ripaaf/ups-orangepizero3w/README.md

# ups-orangepizero3w
trying making a pcb ups for orangepi (its bad)
