ripaaf/ups-orangepizero3w/OrangePi_Zero3W_UPS_RevA.kicad_pcb

## KiCad design OrangePi_Zero3W_UPS_RevA.kicad_pcb (2026-08-08)

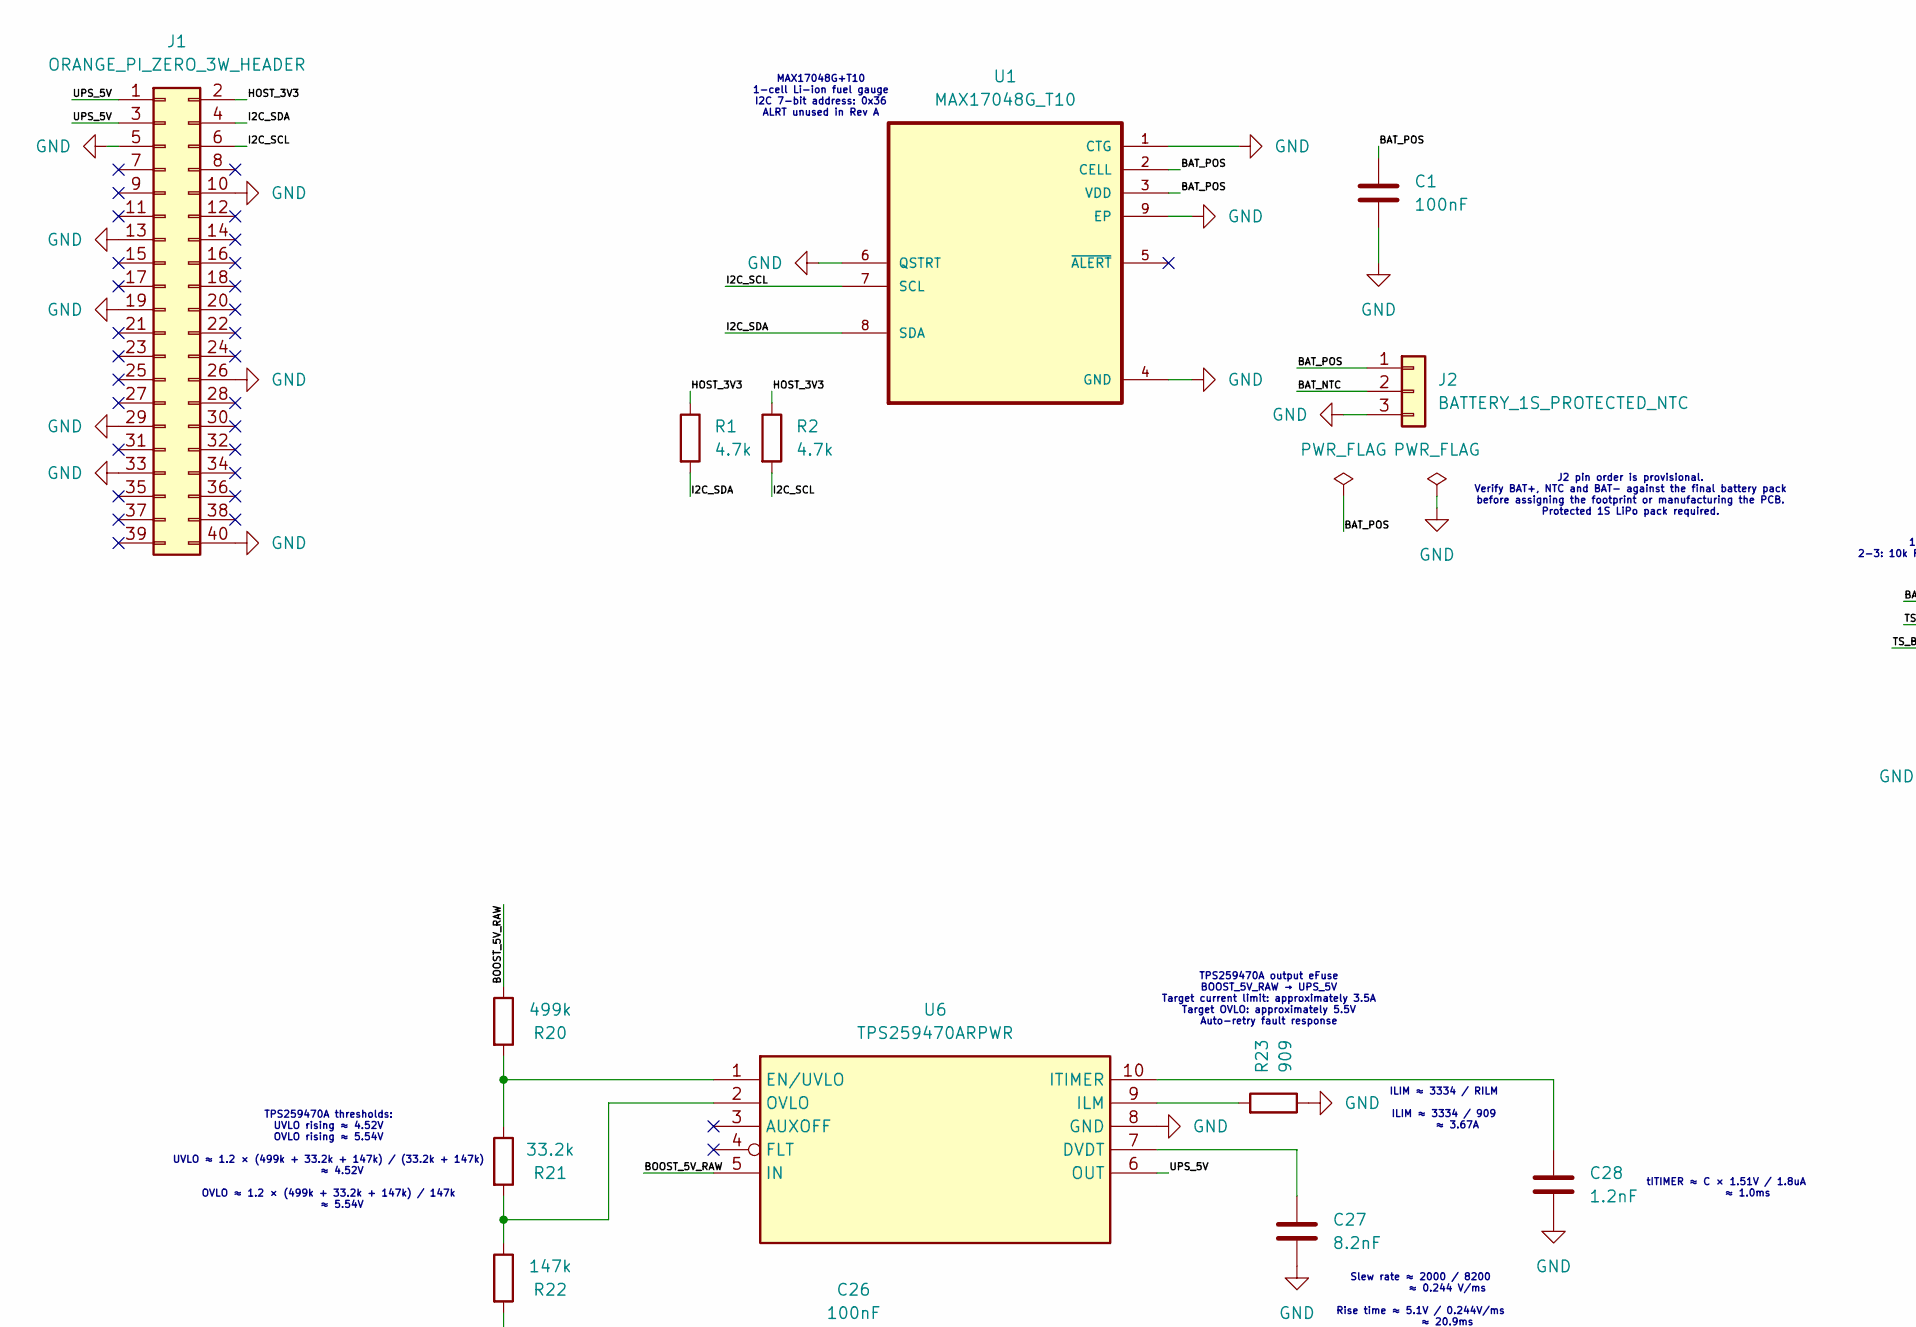
[picture p1: schematic OrangePi_Zero3W_UPS_RevA.kicad_sch, part in row 1, column 1]

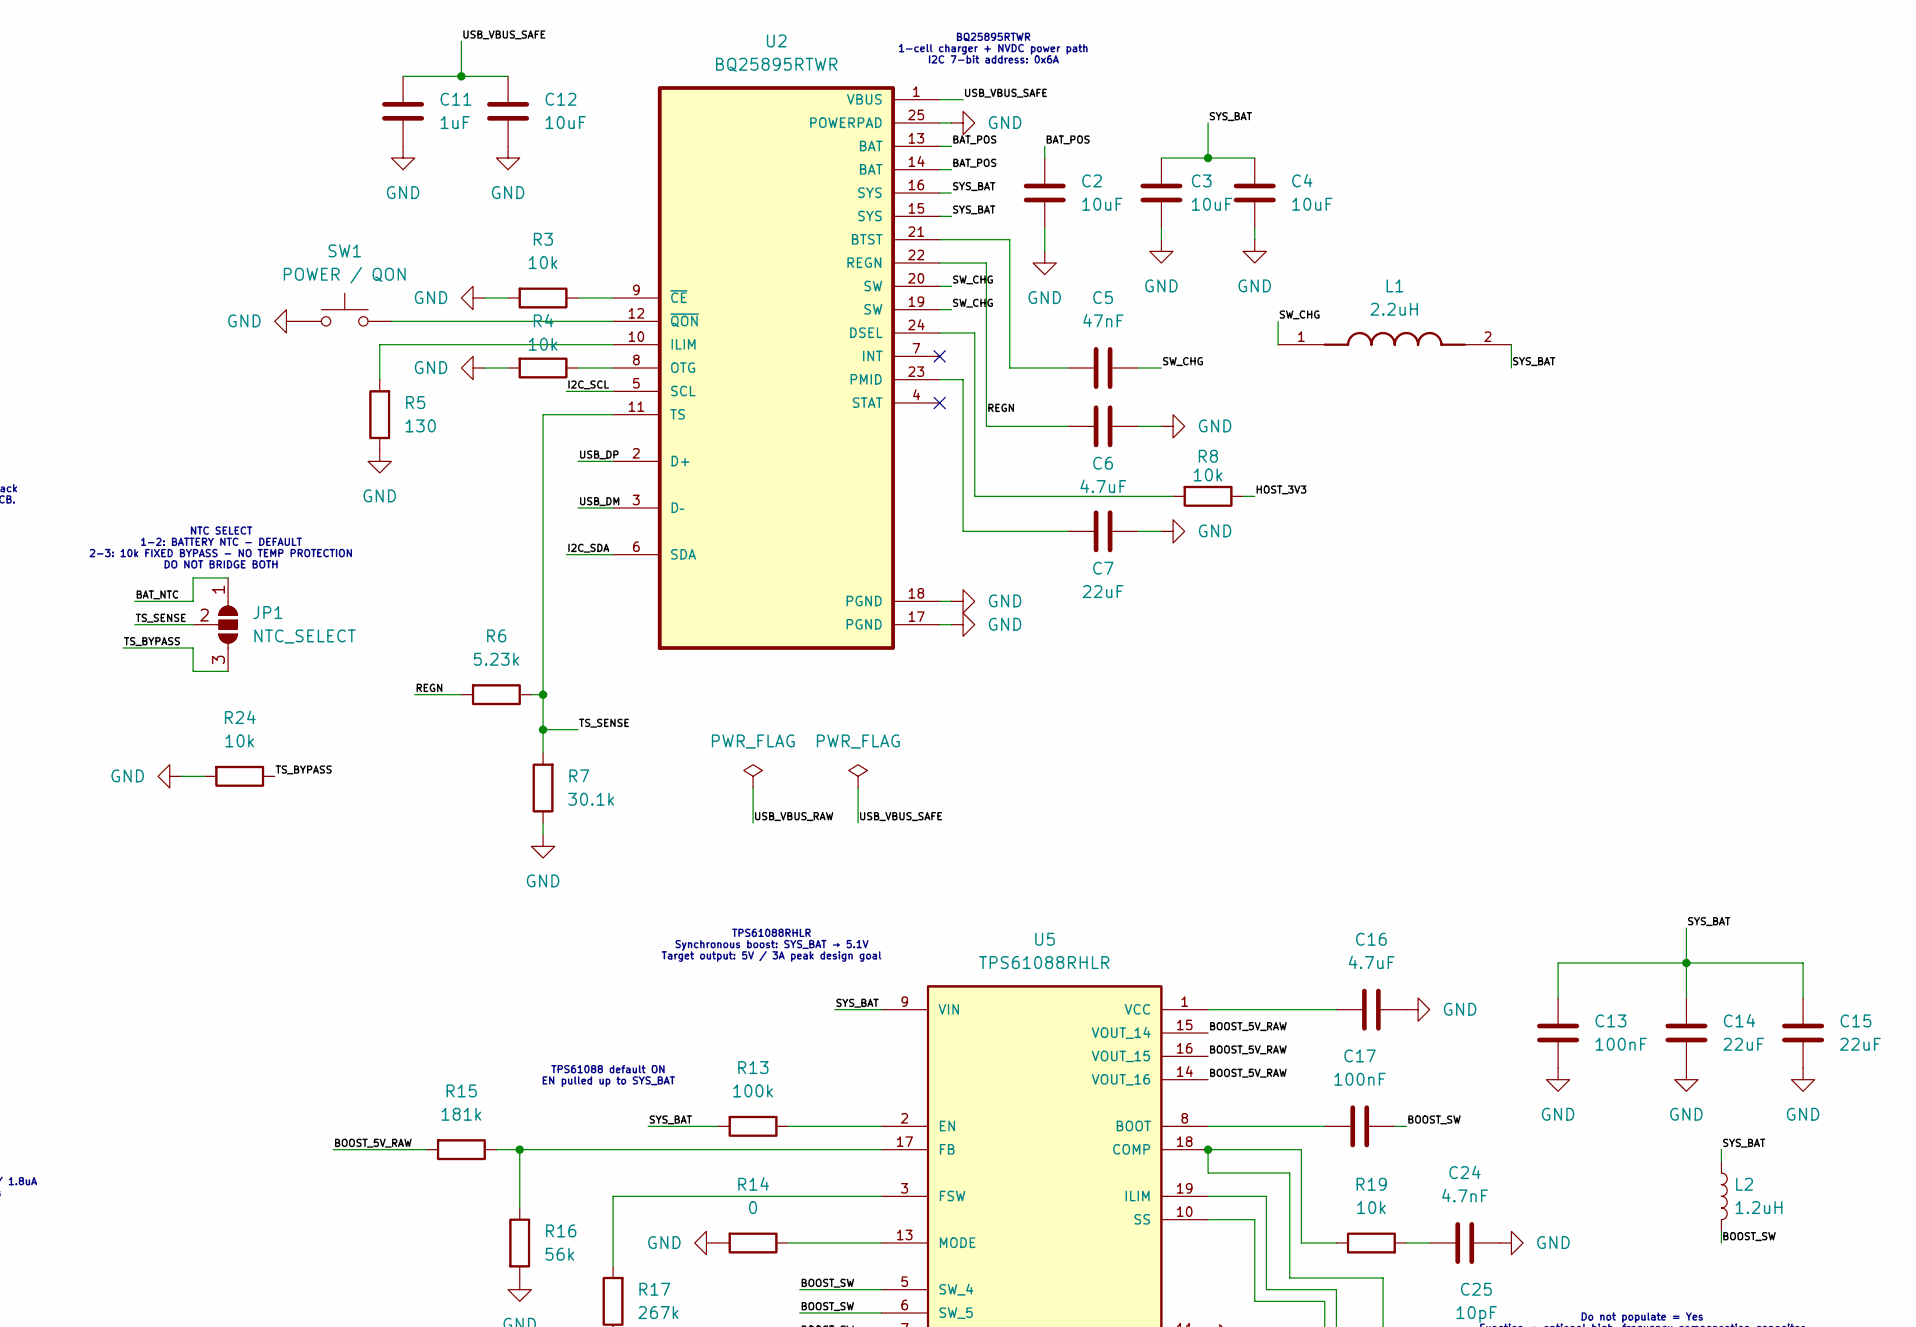
[picture p2: schematic OrangePi_Zero3W_UPS_RevA.kicad_sch, part in row 1, column 2]

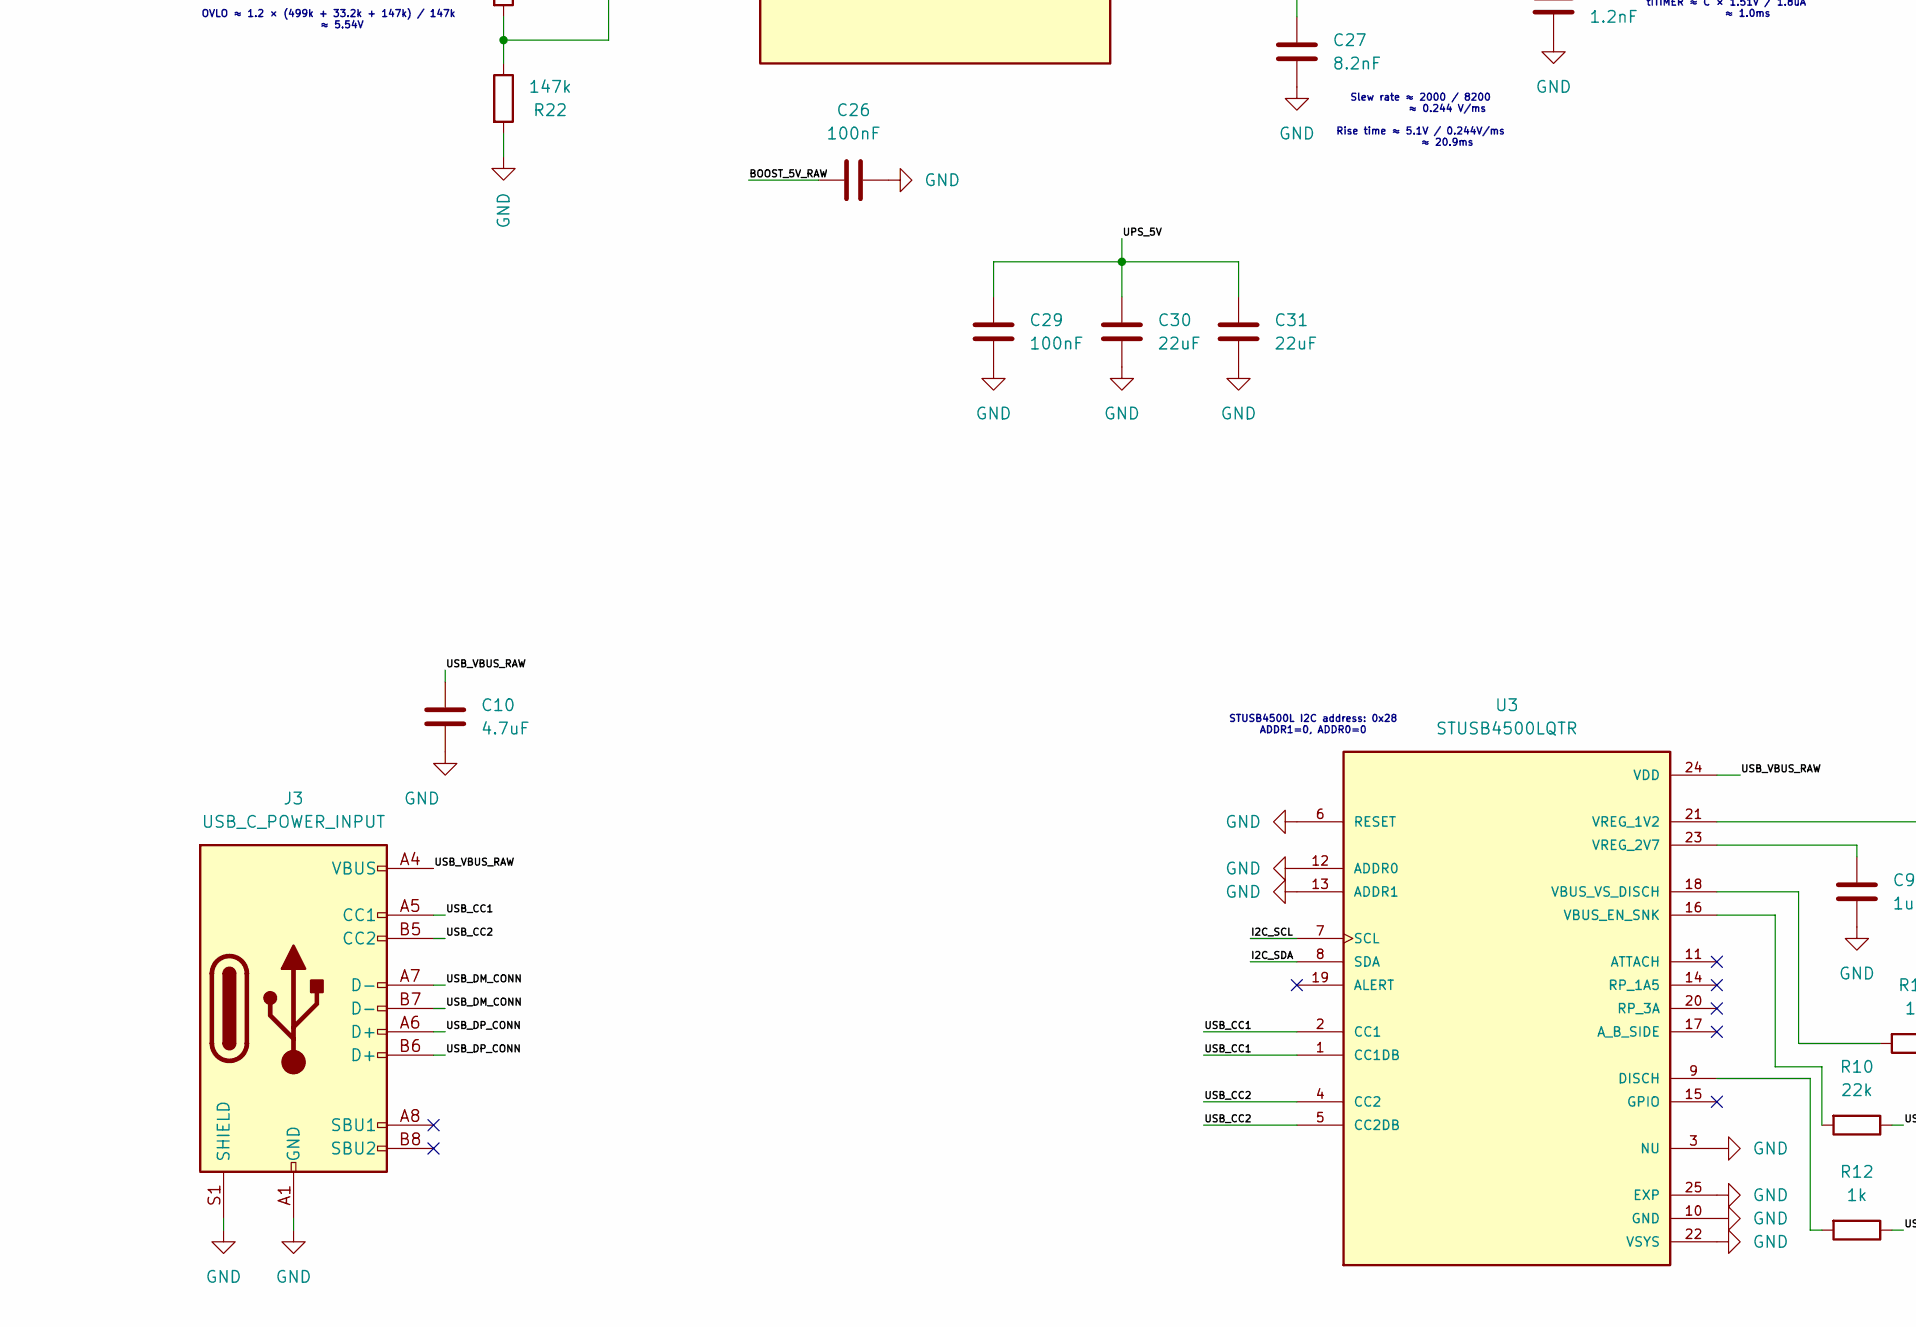
[picture p3: schematic OrangePi_Zero3W_UPS_RevA.kicad_sch, part in row 2, column 1]

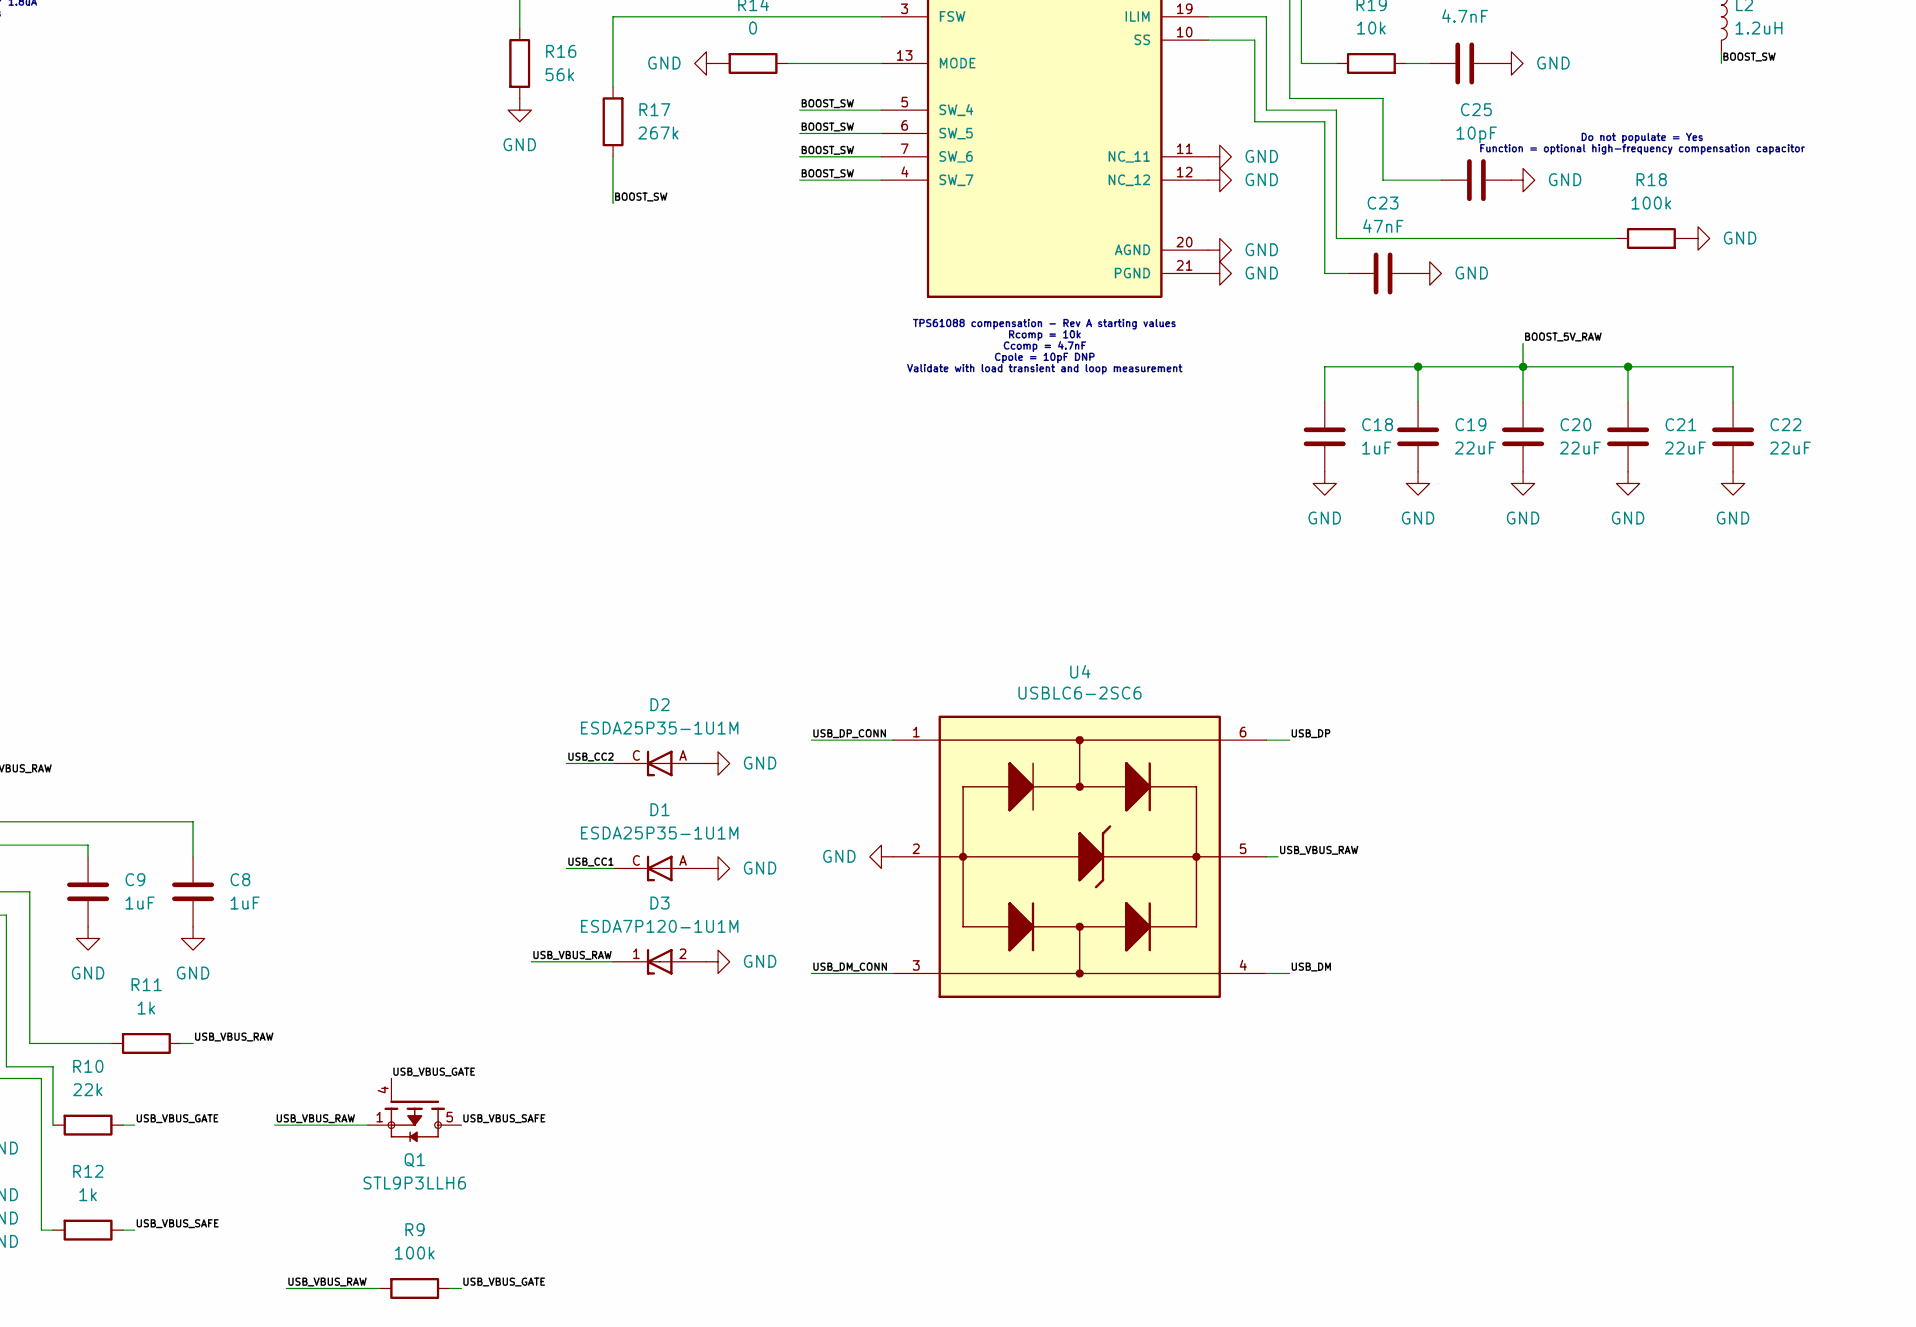
[picture p4: schematic OrangePi_Zero3W_UPS_RevA.kicad_sch, part in row 2, column 2]

Parts:
C1: 100nF; C_0603_1608Metric
C2, C3, C4: 10uF; C_0805_2012Metric
C5: 47nF; C_0402_1005Metric; Voltage minimum 16V
C6, C16: 4.7uF; C_0603_1608Metric; Voltage 10V minimum
C7: 22uF; C_0805_2012Metric; Voltage 25V; MPN GRM21BR61E226ME44
C8, C9: 1uF; C_0603_1608Metric; Voltage 6.3V or higher
C10: 4.7uF; C_0805_2012Metric; Voltage rating minimal 10V
C11: 1uF; C_0805_2012Metric; Voltage rating minimal 25V; MPN GRM219R71E105KA88D
C12: 10uF; C_0805_2012Metric; Voltage rating minimal 25V; MPN C2012X5R1E106K125AB
C13, C26, C29: 100nF; C_0603_1608Metric; Voltage 10V minimum
C14, C15, C19, C20, C21, C22, C30, C31: 22uF; C_1206_3216Metric; Voltage 10V minimum
C17: 100nF; C_0402_1005Metric; Voltage 16V minimum
C18: 1uF; C_0603_1608Metric; Voltage 10V minimum
C23: 47nF; C_0402_1005Metric; Voltage 10V minimum
C24: 4.7nF; C_0402_1005Metric; Voltage 10V minimum
C25: 10pF; C_0402_1005Metric; Voltage 25V atau lebih
C27: 8.2nF; C_0402_1005Metric; Voltage 10V minimum
C28: 1.2nF; C_0402_1005Metric; Voltage 10V minimum
D1, D2: ESDA25P35-1U1M; TVS_ESDA25P35-1U1M; PARTREV 2
D3: ESDA7P120-1U1M; TVS_ESDA7P120-1U1M; PARTREV 4
J1: ORANGE_PI_ZERO_3W_HEADER; PinSocket_2x20_P2.54mm_Vertical
J2: BATTERY_1S_PROTECTED_NTC; JST_PH_S3B-PH-SM4-TB_1x03-1MP_P2.00mm_Horizontal
J3: USB_C_POWER_INPUT; USB_C_Receptacle_JAE_DX07S016JA1R1500; MPN DX07S016JA1R1500
JP1: NTC_SELECT; SolderJumper-3_P1.3mm_Open_Pad1.0x1.5mm_NumberLabels
L1: 2.2uH; INDM686X647X300N; PARTREV 16-Oct-2020
L2: 1.2uH; Coilcraft_XGL6030; Tolerance ±20%; MPN XGL6030-122MEC
Q1: STL9P3LLH6; TRANS_STL9P3LLH6; PARTREV 3
R1, R2: 4.7k; R_0603_1608Metric
R3, R4, R8: 10k; R_0603_1608Metric
R5: 130; R_0603_1608Metric; Tolerance 1%
R6: 5.23k; R_0603_1608Metric; Tolerance 1%
R7: 30.1k; R_0603_1608Metric; Tolerance 1%
R9, R13: 100k; R_0603_1608Metric
R10: 22k; R_0603_1608Metric
R11, R12: 1k; R_0603_1608Metric
R14: 0; R_0603_1608Metric
R15: 181k; R_0603_1608Metric; tolerance 1%
R16: 56k; R_0603_1608Metric; tolerance 1%
R17: 267k; R_0603_1608Metric; tolerance 1%
R18: 100k; R_0603_1608Metric; tolerance 1%
R19: 10k; R_0603_1608Metric; tolerance 1%
R20: 499k; R_0603_1608Metric; tolerance 1%
R21: 33.2k; R_0603_1608Metric; tolerance 1%
R22: 147k; R_0603_1608Metric; tolerance 1%
R23: 909; R_0603_1608Metric; tolerance 1%
R24: 10k; R_0603_1608Metric; Tolerance 1%
SW1: POWER / QON; SW_B3U-1000P
U1: MAX17048G_T10; SON50P200X200X80-9N; MPN MAX17048G+T10
U2: BQ25895RTWR; QFN50P400X400X80-25N; MPN BQ25895RTWR
U3: STUSB4500LQTR; QFN50P400X400X100-25N; PARTREV 4
U4: USBLC6-2SC6; SOT95P280X145-6N; MPN USBLC6-2SC6
U5: TPS61088RHLR; IC_TPS61088RHLR; PARTREV 4219071/A 05/2017; LCSC Part # C87357
U6: TPS259470ARPWR; TPS259470ARPWR_RPW0010A; MPN TPS259470ARPWR

Connections:
/BAT_NTC: J2.2, JP1.1 (A)
/BAT_POS: C1.1, C2.1, J2.1, U1.2 (CELL), U1.3 (VDD), U2.13 (BAT), U2.14 (BAT)
/BOOST_5V_RAW: C18.1, C19.1, C20.1, C21.1, C22.1, C26.2, R15.2, R20.1, U5.14 (VOUT_16), U5.15 (VOUT_14), U5.16 (VOUT_15), U6.5 (IN)
/BOOST_SW: C17.1, L2.2, R17.1, U5.4 (SW_7), U5.5 (SW_4), U5.6 (SW_5), U5.7 (SW_6)
/HOST_3V3: J1.2, R1.1, R2.1, R8.1
/I2C_SCL: J1.6, R2.2, U1.7 (SCL), U2.5 (SCL), U3.7 (SCL)
/I2C_SDA: J1.4, R1.2, U1.8 (SDA), U2.6 (SDA), U3.8 (SDA)
/REGN: C6.2, R6.2, U2.22 (REGN)
/SW_CHG: C5.1, L1.1, U2.19 (SW), U2.20 (SW)
/SYS_BAT: C3.1, C4.1, C13.1, C14.1, C15.1, L1.2, L2.1, R13.2, U2.15 (SYS), U2.16 (SYS), U5.9 (VIN)
/TS_BYPASS: JP1.3 (B), R24.1
/TS_SENSE: JP1.2 (C), R6.1, R7.2, U2.11 (TS)
/UPS_5V: C29.2, C30.2, C31.2, J1.1, J1.3, U6.6 (OUT)
/USB_CC1: D1.C, J3.A5 (CC1), U3.1 (CC1DB), U3.2 (CC1)
/USB_CC2: D2.C, J3.B5 (CC2), U3.4 (CC2), U3.5 (CC2DB)
/USB_DM: U2.3 (D–), U4.4
/USB_DM_CONN: J3.A7 (D-), J3.B7 (D-), U4.3
/USB_DP: U2.2 (D+), U4.6
/USB_DP_CONN: J3.A6 (D+), J3.B6 (D+), U4.1
/USB_VBUS_GATE: Q1.4, R9.1, R10.1
/USB_VBUS_RAW: C10.1, D3.1, J3.A4 (VBUS), J3.A9 (VBUS), J3.B4 (VBUS), J3.B9 (VBUS), Q1.1, Q1.2, Q1.3, R9.2, R11.1, U3.24 (VDD), U4.5
/USB_VBUS_SAFE: C11.1, C12.1, Q1.5, Q1.5_1, Q1.5_2, R12.1, U2.1 (VBUS)
GND: C1.2, C2.2, C3.2, C4.2, C6.1, C7.2, C8.2, C9.2, C10.2, C11.2, C12.2, C13.2, C14.2, C15.2, C16.2, C18.2, C19.2, C20.2, C21.2, C22.2, C23.1, C24.1, C25.1, C26.1, C27.1, C28.1, C29.1, C30.1, C31.1, D1.A, D2.A, D3.2, J1.5, J1.10, J1.13, J1.19, J1.26, J1.29, J1.33, J1.40, J2.3, J3.A1 (GND), J3.A12 (GND), J3.B1 (GND), J3.B12 (GND), J3.S1 (SHIELD), R3.2, R4.2, R5.1, R7.1, R14.2, R16.2, R18.2, R22.2, R23.1, R24.2, SW1.1, U1.1 (CTG), U1.4 (GND), U1.6 (QSTRT), U1.9 (EP), U2.17 (PGND), U2.18 (PGND), U2.25 (POWERPAD), U3.3 (NU), U3.6 (RESET), U3.10 (GND), U3.12 (ADDR0), U3.13 (ADDR1), U3.22 (VSYS), U3.25 (EXP), U4.2, U5.11 (NC_11), U5.12 (NC_12), U5.20 (AGND), U5.21 (PGND), U6.8 (GND)
unnamed: C24.2, R19.2
unnamed: C5.2, U2.21 (BTST)
unnamed: R8.2, U2.24 (DSEL)
unnamed: R5.2, U2.10 (ILIM)
unnamed: R4.1, U2.8 (OTG)
unnamed: C7.1, U2.23 (PMID)
unnamed: R3.1, U2.9 (~CE)
unnamed: SW1.2, U2.12 (~QON)
unnamed: R12.2, U3.9 (DISCH)
unnamed: R10.2, U3.16 (VBUS_EN_SNK)
unnamed: R11.2, U3.18 (VBUS_VS_DISCH)
unnamed: C8.1, U3.21 (VREG_1V2)
unnamed: C9.1, U3.23 (VREG_2V7)
unnamed: C17.2, U5.8 (BOOT)
unnamed: C25.2, R19.1, U5.18 (COMP)
unnamed: R13.1, U5.2 (EN)
unnamed: R15.1, R16.1, U5.17 (FB)
unnamed: R17.2, U5.3 (FSW)
unnamed: R18.1, U5.19 (ILIM)
unnamed: R14.1, U5.13 (MODE)
unnamed: C23.2, U5.10 (SS)
unnamed: C16.1, U5.1 (VCC)
unnamed: C27.2, U6.7 (DVDT)
unnamed: R20.2, R21.1, U6.1 (EN/UVLO)
unnamed: R23.2, U6.9 (ILM)
unnamed: C28.2, U6.10 (ITIMER)
unnamed: R21.2, R22.1, U6.2 (OVLO)

Notes on the sheet:
NTC SELECT 1-2: BATTERY NTC - DEFAULT 2-3: 10k FIXED BYPASS - NO TEMP PROTECTION DO NOT BRIDGE BOTH
TPS61088RHLR Synchronous boost: SYS_BAT → 5.1V Target output: 5V / 3A peak design goal
STUSB4500L I2C address: 0x28 ADDR1=0, ADDR0=0
Slew rate ≈ 2000 / 8200 ≈ 0.244 V/ms Rise time ≈ 5.1V / 0.244V/ms ≈ 20.9ms
Do not populate = Yes Function = optional high-frequency compensation capacitor
J2 pin order is provisional. Verify BAT+, NTC and BAT- against the final battery pack before assigning the footprint or manufacturing the PCB. Protected 1S LiPo pack required.
TPS61088 default ON EN pulled up to SYS_BAT
TPS259470A output eFuse BOOST_5V_RAW → UPS_5V Target current limit: approximately 3.5A Target OVLO: approximately 5.5V Auto-retry fault response
tITIMER ≈ C × 1.51V / 1.8uA ≈ 1.0ms
ILIM ≈ 3334 / RILM ILIM ≈ 3334 / 909 ≈ 3.67A
TPS259470A thresholds: UVLO rising ≈ 4.52V OVLO rising ≈ 5.54V UVLO ≈ 1.2 × (499k + 33.2k + 147k) / (33.2k + 147k) ≈ 4.52V OVLO ≈ 1.2 × (499k + 33.2k + 147k) / 147k ≈ 5.54V
TPS61088 compensation - Rev A starting values Rcomp = 10k Ccomp = 4.7nF Cpole = 10pF DNP Validate with load transient and loop measurement
BQ25895RTWR 1-cell charger + NVDC power path I2C 7-bit address: 0x6A
MAX17048G+T10 1-cell Li-ion fuel gauge I2C 7-bit address: 0x36 ALRT unused in Rev A

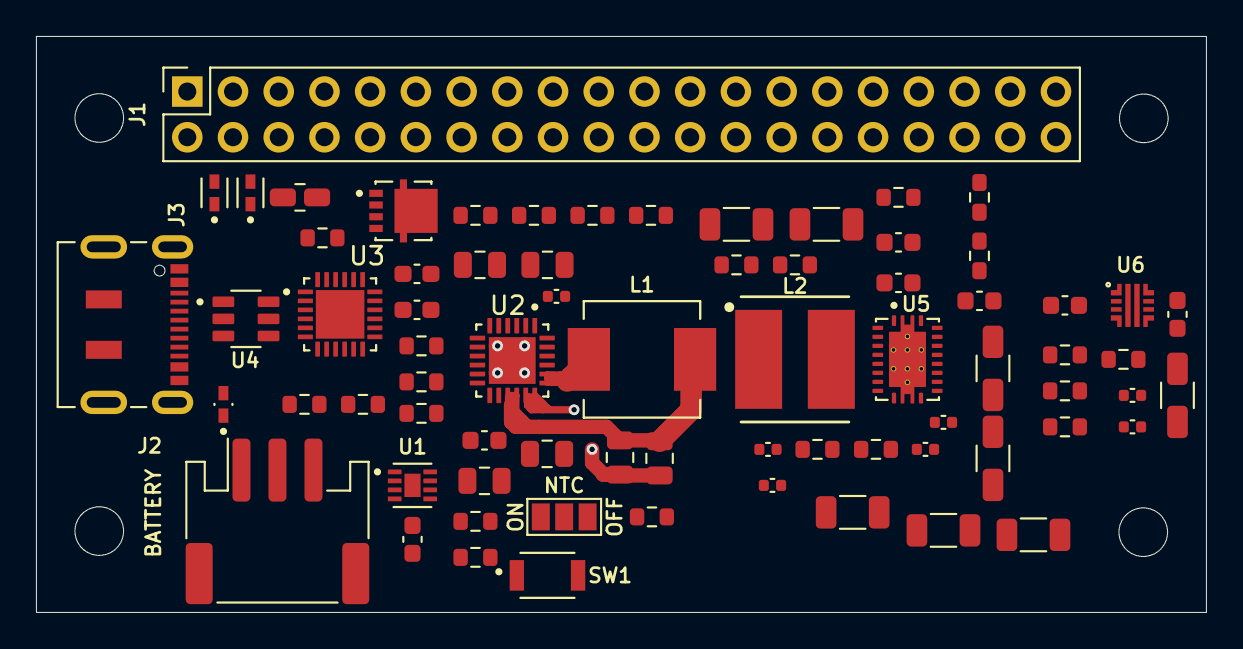
[picture p5: board OrangePi_Zero3W_UPS_RevA.kicad_pcb from above]

Board: 4 copper layers, 65.0 x 32.0 mm, 72 parts (0 on the bottom side), 50 nets.
