ripaaf/ups-orangepizero3w/(commit log)

2026-07-31 phase 4
    [OrangePi_Zero3W_UPS_RevA.kicad_pcb, OrangePi_Zero3W_UPS_RevA.kicad_sch]
2026-08-01 update phase 5A.1
    [OrangePi_Zero3W_UPS_RevA.kicad_pcb, OrangePi_Zero3W_UPS_RevA.kicad_sch]
2026-08-01 phase 5a.1 revision
    [OrangePi_Zero3W_UPS_RevA.kicad_pcb]
2026-08-01 phase 5A.2
    [OrangePi_Zero3W_UPS_RevA.kicad_sch]
2026-08-01 phase 5A.2 revisi
    [OrangePi_Zero3W_UPS_RevA.kicad_pcb]
2026-08-01 Phase 5A.3: add provisional protected battery interface
    [OrangePi_Zero3W_UPS_RevA.kicad_sch]
2026-08-01 phase 5B.1B
    [OrangePi_Zero3W_UPS_RevA.kicad_pcb, OrangePi_Zero3W_UPS_RevA.kicad_sch]
2026-08-01 Phase 5B.1C: add BQ25895 switching and bias components
    [OrangePi_Zero3W_UPS_RevA.kicad_sch]
2026-08-01 Phase 5B.1D: add charger I2C, ILIM and battery temperature network
    [OrangePi_Zero3W_UPS_RevA.kicad_sch]
2026-08-01 Phase 5B.1E: finalize BQ25895 control and status pins
    [OrangePi_Zero3W_UPS_RevA.kicad_sch]
2026-08-01 Phase 5B.1E fix: correct BQ25895 symbol electrical types
    [OrangePi_Zero3W_UPS_RevA.kicad_sch]
2026-08-02 Phase 5B.2B: connect USB-C CC, data and STUSB4500L core
    [OrangePi_Zero3W_UPS_RevA.kicad_sch]
2026-08-02 Phase 5B.2C: add USB-C VBUS switch and monitoring path
    [OrangePi_Zero3W_UPS_RevA.kicad_sch]
2026-08-02 Phase 5B.2C fix: correct PMOS source and drain orientation
    [OrangePi_Zero3W_UPS_RevA.kicad_sch]
2026-08-02 Phase 5B.2D: add USB-C ESD and VBUS surge protection
    [OrangePi_Zero3W_UPS_RevA.kicad_sch]
2026-08-02 Phase 5B.3: audit charger and USB-C input schematic
    [OrangePi_Zero3W_UPS_RevA.kicad_sch]
2026-08-02 Phase 5C.1: import and validate TPS61088 boost converter
    [OrangePi_Zero3W_UPS_RevA.kicad_sch]
2026-08-02 Phase 5C.2A: add TPS61088 input supply and control configuration
    [OrangePi_Zero3W_UPS_RevA.kicad_sch]
2026-08-02 Phase 5C.2B: add TPS61088 boost power stage and output capacitors
    [OrangePi_Zero3W_UPS_RevA.kicad_sch]
2026-08-02 Phase 5C.2B fix: normalize TPS61088 exposed pad to pin 21
    [OrangePi_Zero3W_UPS_RevA.kicad_sch]
2026-08-02 phase 5c.2c1
    [OrangePi_Zero3W_UPS_RevA.kicad_sch]
2026-08-02 Phase 5C.2C2: set TPS61088 switching frequency and current limit
    [OrangePi_Zero3W_UPS_RevA.kicad_sch]
2026-08-02 Phase 5C.2C3: add TPS61088 compensation network
    [OrangePi_Zero3W_UPS_RevA.kicad_sch]
2026-08-03 Phase 5D.2: configure output eFuse and connect UPS 5V rail
    [OrangePi_Zero3W_UPS_RevA.kicad_sch]
2026-08-03 Phase 6A.1: synchronize schematic footprints to PCB staging area
    [OrangePi_Zero3W_UPS_RevA.kicad_pcb]
2026-08-03 Phase 6A.1 fix: assign battery connector, inductors and QON switch footprints
    [OrangePi_Zero3W_UPS_RevA.kicad_pcb, OrangePi_Zero3W_UPS_RevA.kicad_sch]
2026-08-03 Phase 6A.1b: relink PCB footprints and normalize silkscreen
    [OrangePi_Zero3W_UPS_RevA.kicad_pcb]
2026-08-03 Phase 6B.1: configure 4-layer stackup and PCB net classes
    [OrangePi_Zero3W_UPS_RevA_before_routing.kicad_pcb]
2026-08-03 warning cleaning
    [OrangePi_Zero3W_UPS_RevA_before_silkscreen_cleanup.kicad_pcb]
2026-08-03 Phase 6B.1d: add local IC footprint clearance rules
    [OrangePi_Zero3W_UPS_RevA.kicad_pcb]
2026-08-03 Phase 6B.2A: add continuous In1 ground plane
    [OrangePi_Zero3W_UPS_RevA.kicad_pcb]
2026-08-05 Phase 6B.2B1: optimize BQ25895 charger power-loop placement
    [OrangePi_Zero3W_UPS_RevA_before_power_placement.kicad_pcb]
2026-08-05 Phase 6B.2B1a: tighten BQ25895 bootstrap and switch-loop placement
    [OrangePi_Zero3W_UPS_RevA.kicad_pcb]
2026-08-05 Phase 6B.2B2: optimize TPS61088 boost power-loop placement
    [OrangePi_Zero3W_UPS_RevA.kicad_pcb]
2026-08-05 Phase 6B.2B3: optimize TPS25947 output eFuse placement
    [OrangePi_Zero3W_UPS_RevA.kicad_pcb]
2026-08-05 Phase 6B.2B4: optimize USB-C STUSB4500 and ESD placement
    [OrangePi_Zero3W_UPS_RevA.kicad_pcb]
2026-08-05 Phase 6B.2B5: finalize placement clearance and assembly review
    [OrangePi_Zero3W_UPS_RevA.kicad_pcb]
2026-08-05 Phase 6B.2B2 — TPS61088, Phase 6B.2B3 — TPS25947, Phase 6B.2B4 — USB-C/STUSB4500L/ESD, Phase 6B.2B5 — final placement review
2026-08-06 Phase 6C.1B — Node SYS_BAT lokal
    [OrangePi_Zero3W_UPS_RevA.kicad_pcb]
2026-08-06 Phase 6C.1C — BQ25895 local PGND return
    [OrangePi_Zero3W_UPS_RevA.kicad_pcb]
2026-08-06 Phase 6C.1D — Selectable NTC / TS ECO, Phase 6C.1D-B — update PCB dan placement jumper NTC
    [OrangePi_Zero3W_UPS_RevA.kicad_pcb, OrangePi_Zero3W_UPS_RevA.kicad_sch]
